Elecrow-RD/All-in-one_Starter_Kit_for_Arduino/schematic diagram/All_in_one Starter Kit for Arduino_V1.0.pdf

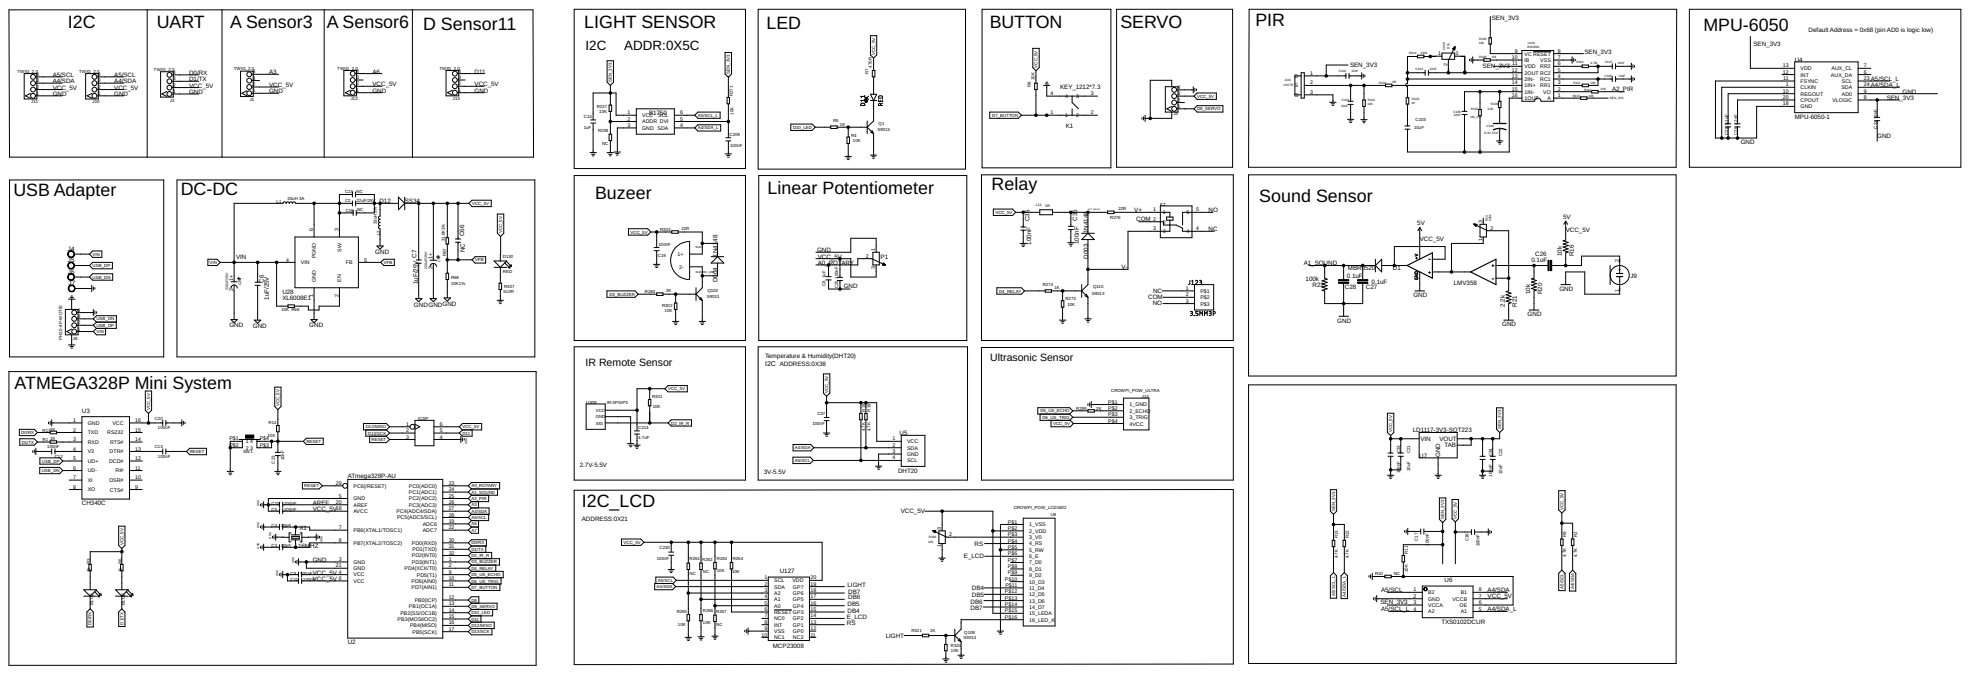
[picture p1: page 1]
