Elecrow-RD/All-in-one_Starter_Kit_for_Arduino/schematic diagram/All_in_one Starter Kit for Arduino_V1.0.brd

## EAGLE design schematic diagram/All_in_one Starter Kit for Arduino_V1.0.brd (2025-01-15)

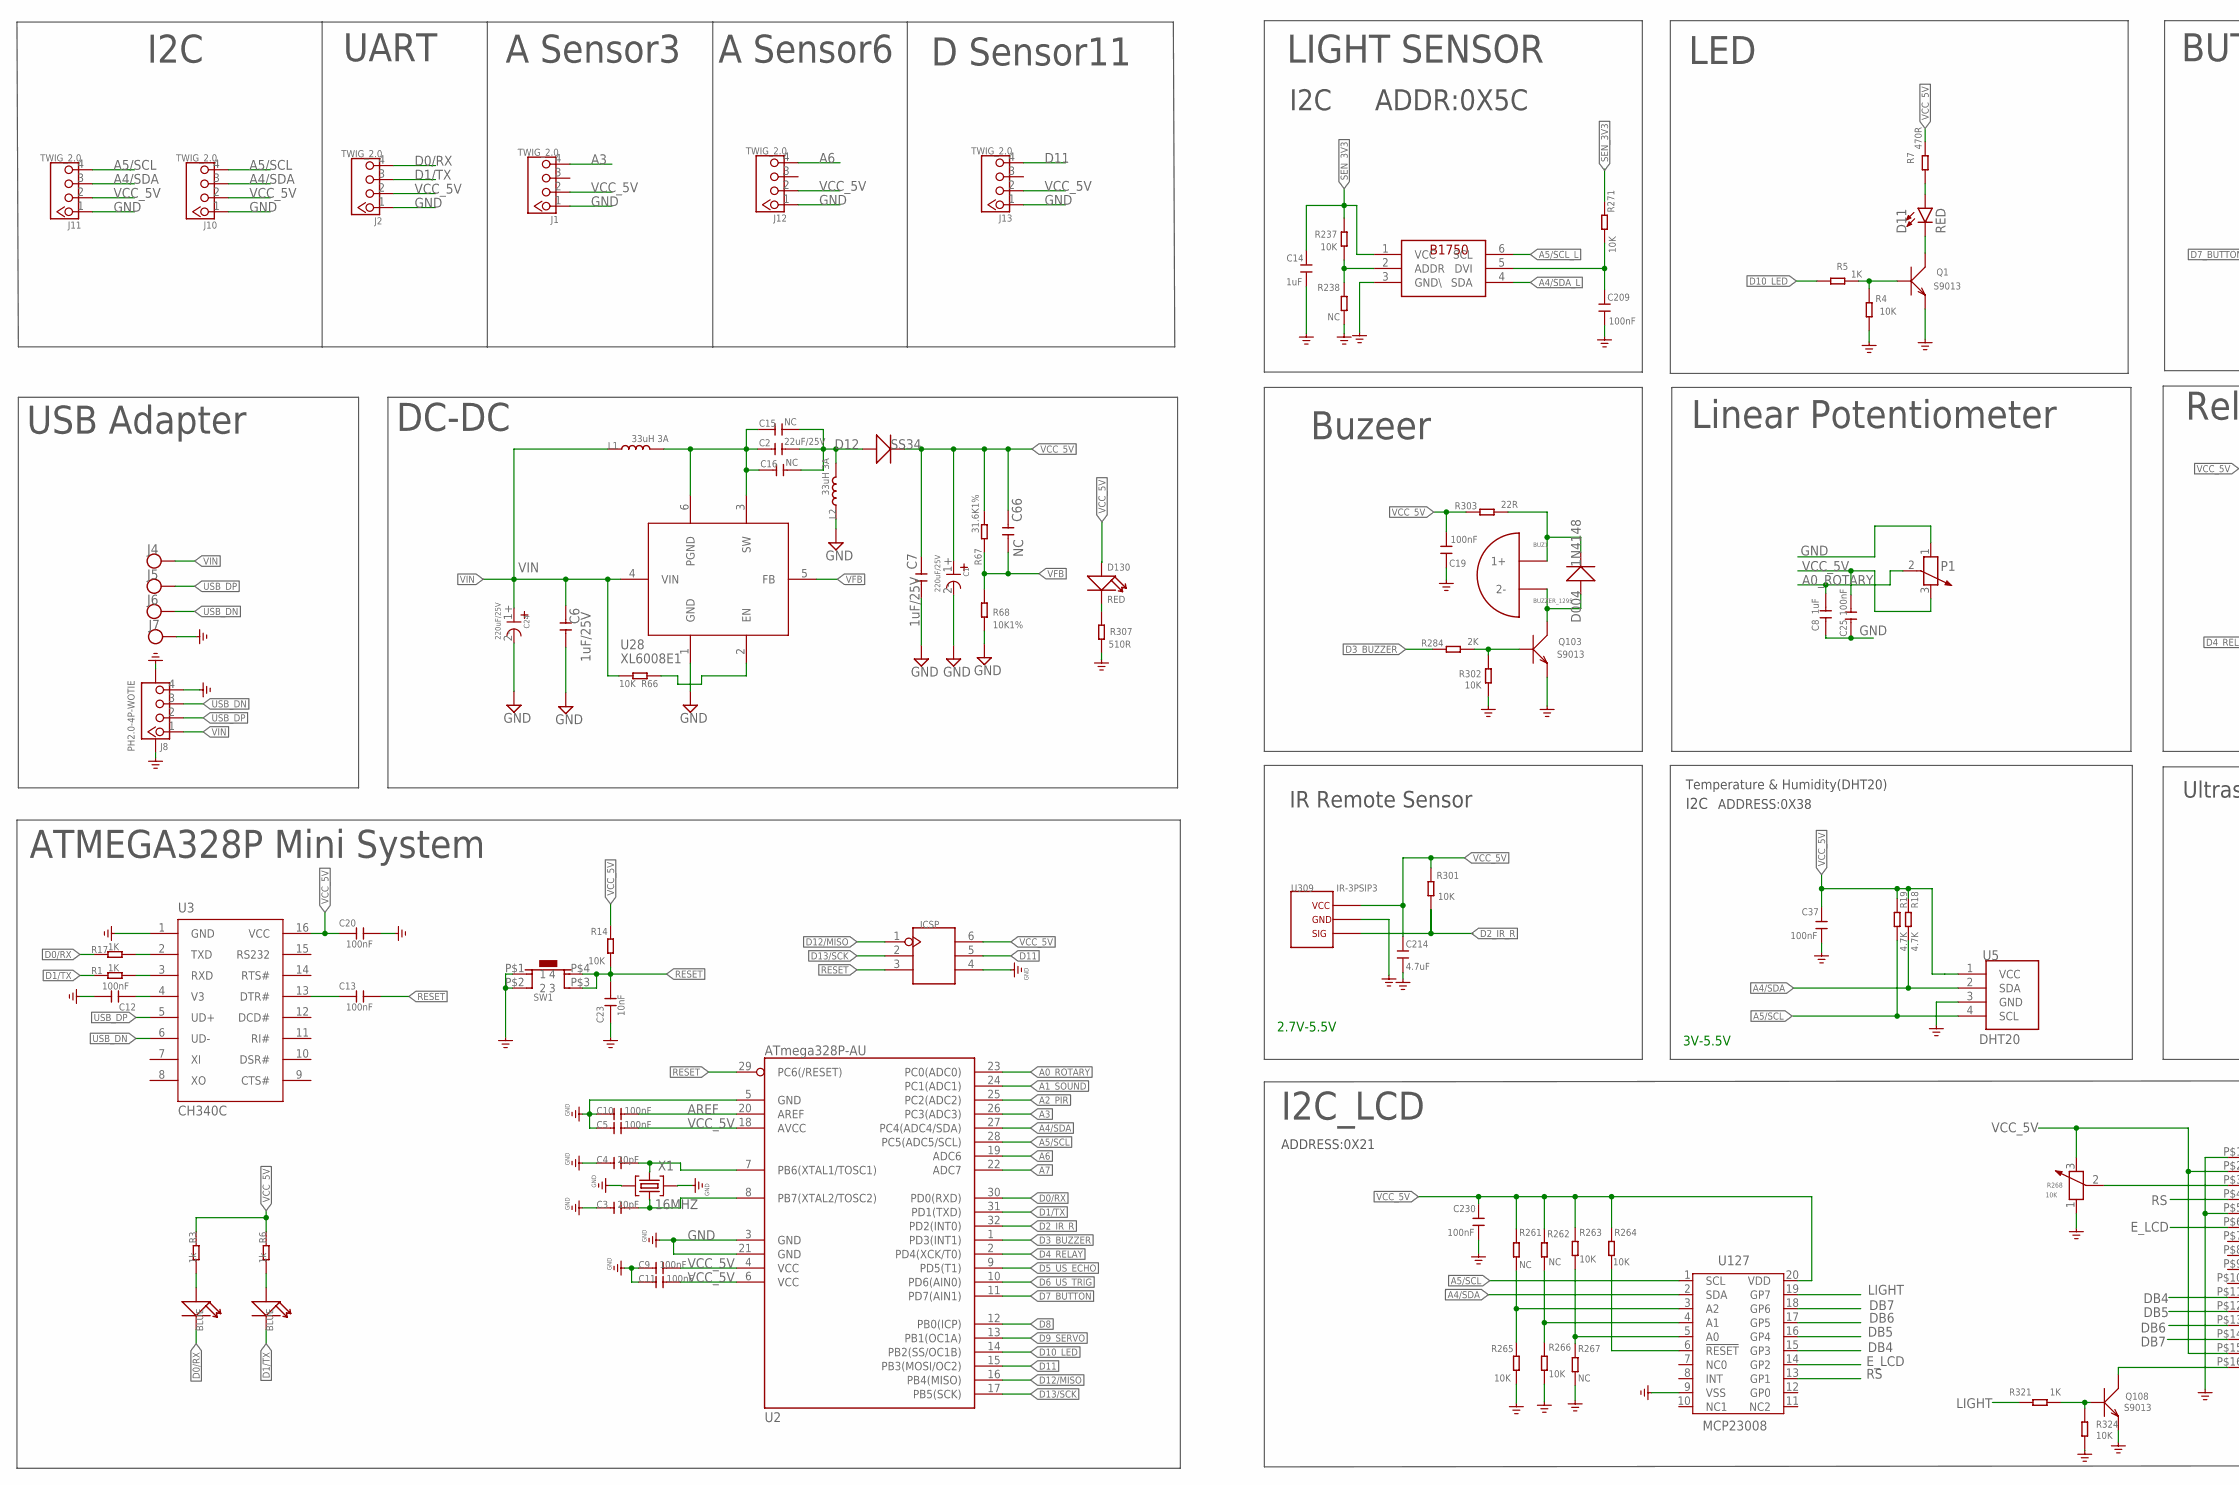
[picture p2: schematic All_in_one Starter Kit for Arduino_V1.0.sch, part in row 1, column 1]

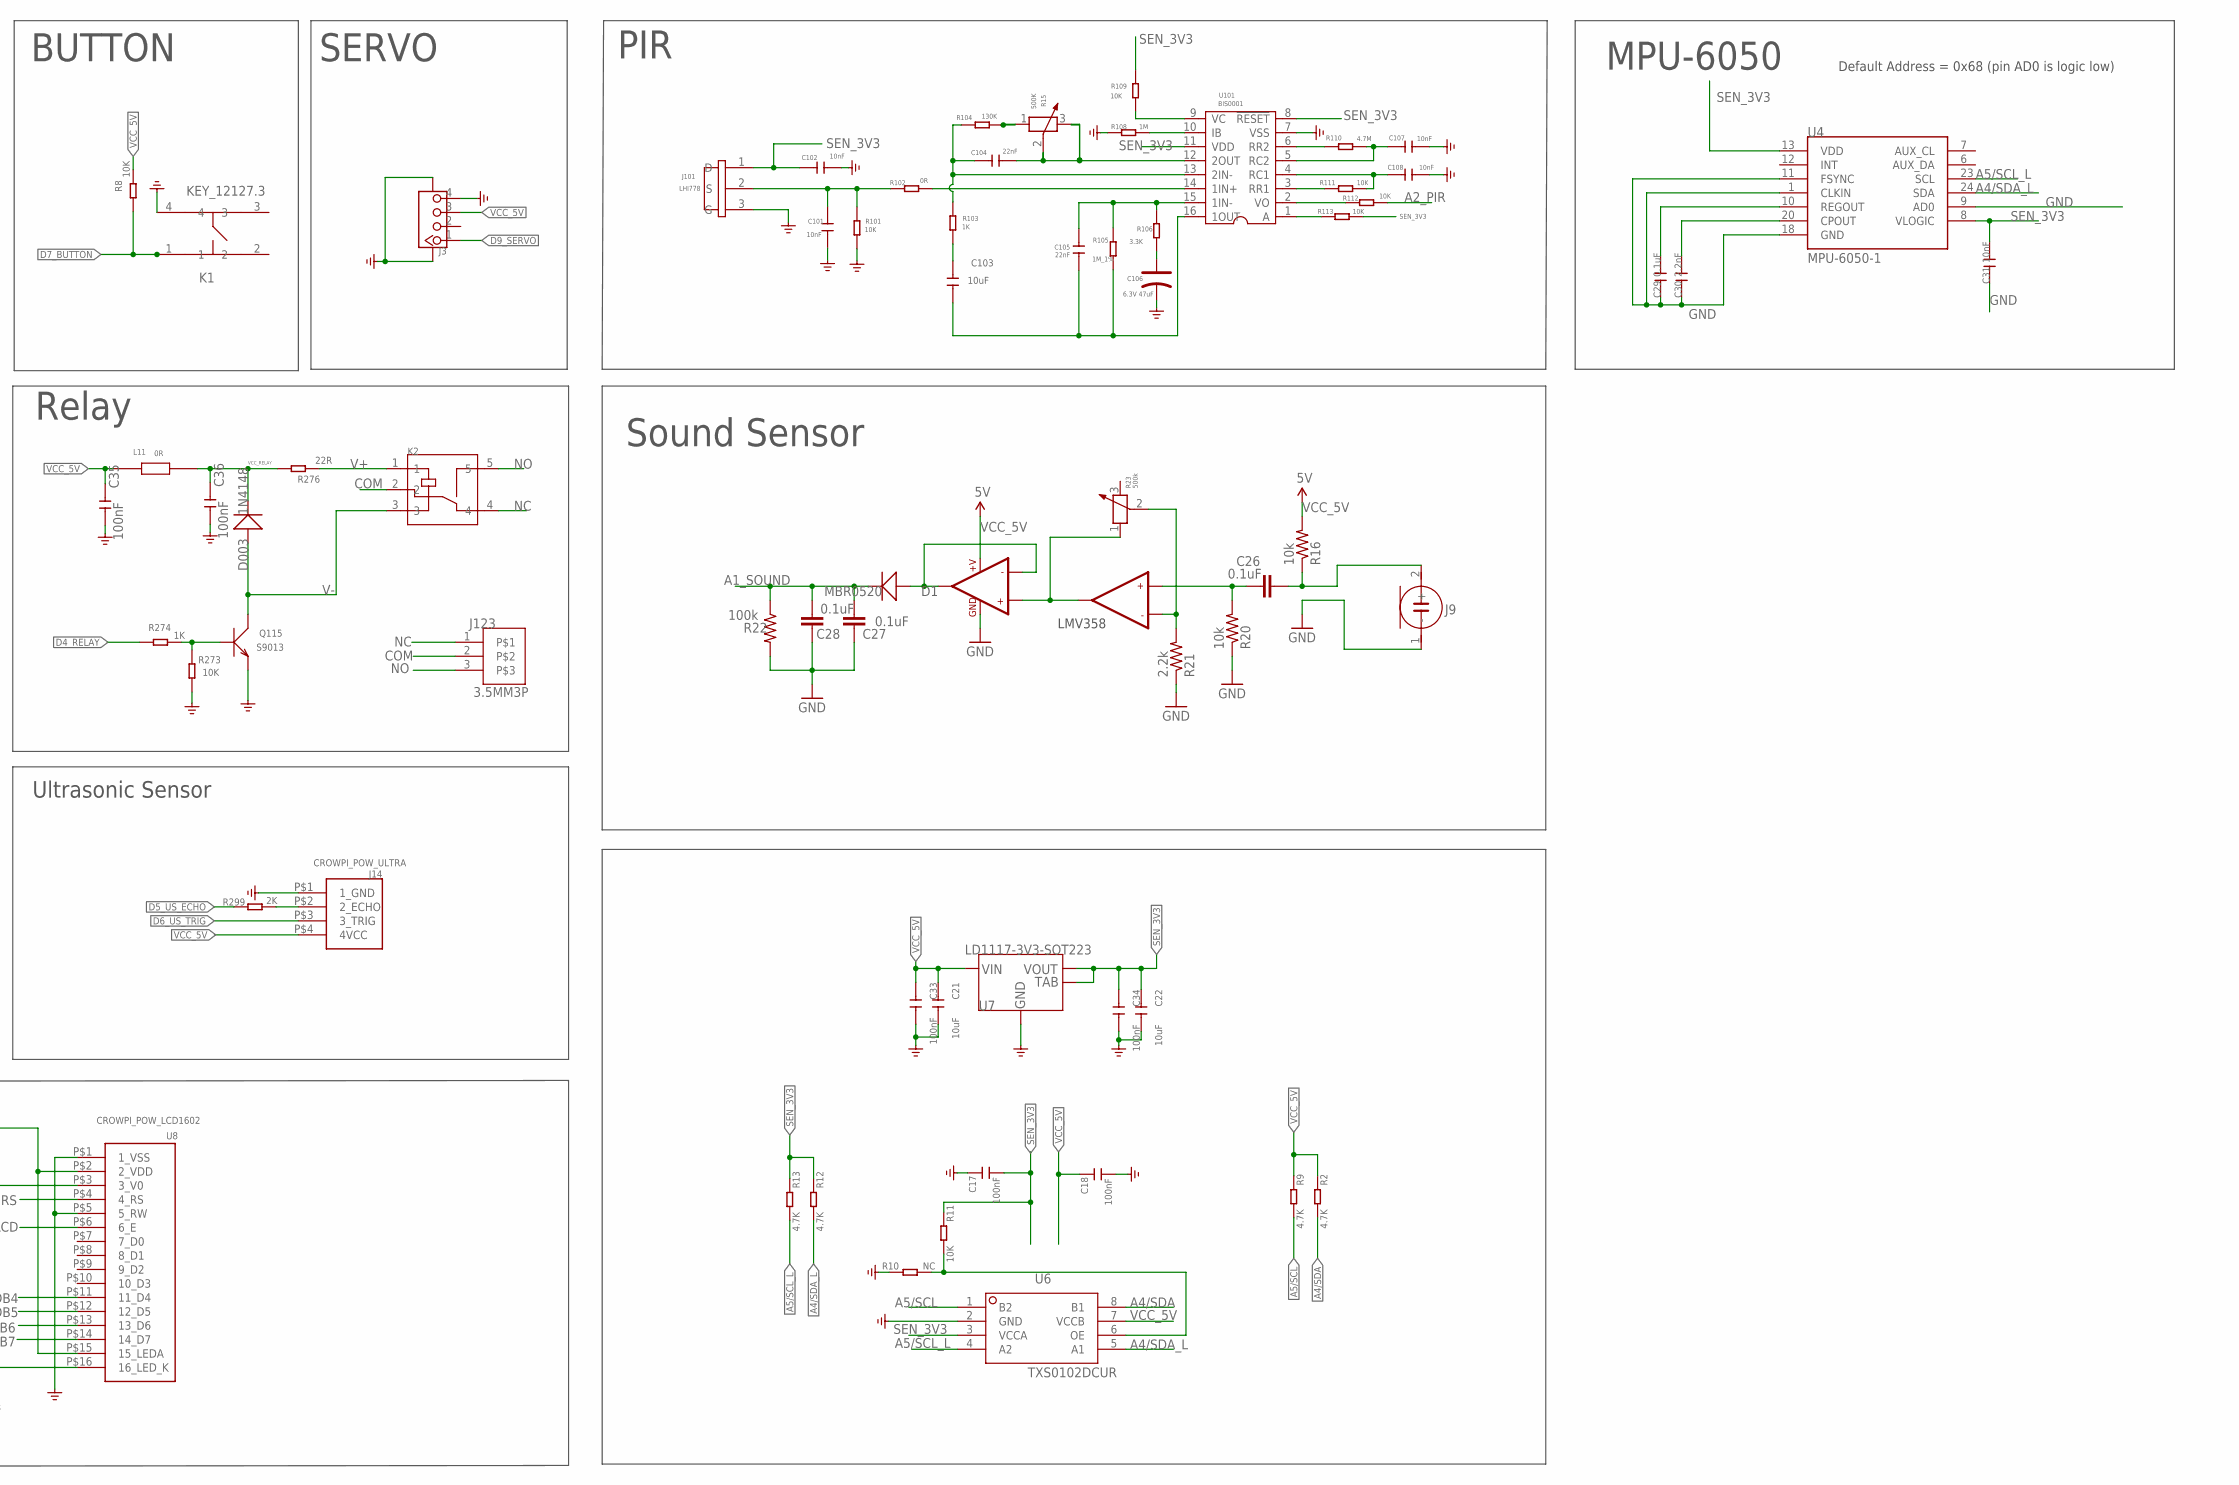
[picture p3: schematic All_in_one Starter Kit for Arduino_V1.0.sch, part in row 1, column 2]

Parts:
BUZ1: BUZZER_1295; BUZZER-D12MM-DIP2
C1, C24: 220uF/25V; CAP_SMD_6.3*5.4MM
C2: 22uF/25V; C0805
C3, C4: 20pF; C0603
C5, C9, C10, C11, C12, C13, C20, C25, C33, C34, C35, C36: 100nF; C0603
C6, C7: 1uF/25V; C0603
C8: 1uF; C0603
C14: 1uF; 0603
C15, C16: NC; C0805
C17, C18, C19, C37, C209, C230: 100nF; 0603
C21, C22: 10uF; C0603
C23, C31, C101, C102, C107, C108: 10nF; C0603
C26, C27, C28: 0.1uF; 0603-CAP
C29: 0.1uF; C0603
C30: 2.2nF; C0603
C66: NC; C0603
C103: 10uF; 0603
C104, C105: 22nF; C0603
C106: 6.3V 47uF; AVX-A
C214: 4.7uF; 0603
D1: MBR0520; SOD123-2.7X1.6
D003, D004: 1N4148; D_SOD123
D11: RED; LED-8MM
D12: SS34; SMA
D13, D14: BLUE; LED-0603
D130: RED; LED_0603_SMT
ICSP: 2.54-2x3p male; 2X3P-2.54
J1, J2, J10, J11, J12, J13: TWIG_2.0; 2.0_1X4
J3: A_XBJ_CONNECTOR_TWIG-4P-2.0-SMD-FEMALE-REINFORCE9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; A_XBJ_CONNECTOR_4P-SMD-2.0-90D
J4, J5, J6, J7: TP-SMDTP-SMD-2X4MM; TP-SMD-2X4MM
J8: PH2.0-4P-WOTIE; PH2.0-4P
J9: TEMPLATE_MIC-6MM; TEMPLATE_2P-D6MM
J14: CROWPI_POW_ULTRA
J101: LHI778; 3P-D8.1MM
J123: 3.5MM3P; 3.5MM*3P
K1: KEY_12127.3; KEY_12*12*7.3
K2: RELAY-SRD; REY5-6-19.1X15.5X15.3MM
L1, L2: 33uH 3A; L1040-SMD
L11: 0R; 201209
P1: R-POTENTIOMETER; 3P-SQUA-45.6X10X5.8H
Q1, Q103, Q108, Q115: S9013; SOT23@1
R1, R5, R17, R103, R274, R321: 1K; R0603
R2, R9, R12, R13, R18, R19: 4.7K; R0603
R3, R6: 1k; R0603
R4, R8, R11, R14, R66, R101, R109, R111, R112, R113, R237, R263, R264, R265, R266, R271, R273, R301, R302, R324: 10K; R0603
R7: 470R; R0603
R10, R238, R261, R262, R267: NC; R0603
R15: 500K; 3P-SMD-SQUA-3.6X3.3
R16, R20: 10k; 0603-RES
R21: 2.2k; 0603-RES
R22: 100k; 0603-RES
R23: 500k; 3P-SMD-SQUA-3.6X3.3
R67: 31.6K1%; R0603
R68: 10K1%; R0603
R102: 0R; R0603
R104: 130K; R0603
R105: 1M_1%; R0603
R106: 3.3K; R0603
R108: 1M; R0603
R110: 4.7M; R0603
R268: 10K; 3P-SMD-SQUA-3.6X3.3
R276, R303: 22R; R0603
R284, R299: 2K; R0603
R307: 510R; R0603
SW1: BUTTON-4P-SMD4.2X3.2; BUTTON-SMD4P-4.2X3.2X2.5
U1: LMV358; SO08
U2: ATmega328P-AU; TQFP32
U3: CH340C; SOP-16
U4: MPU-6050-1; QFN-24-4MM2
U5: DHT20; CROWTAIL-DHT20-V1.0-20211013_DHT20
U6: TXS0102DCUR; VSSOP-8
U7: LD1117-3V3-SOT223; SOT223
U8: CROWPI_POW_LCD1602; CROWPI_POW_LCD1206
U28: XL6008E1; TO252-5
U101: BIS0001; SOP16
U121: BH1750; BH1750-WSOF-6
U127: MCP23008; SSOP20
U309: IR-3PSIP3; VS1838B-SIP3
X1: 16MHZ; CRYSTAL-3.2-2.5

Connections:
A0_ROTARY: C8.2, P1.2 (3), U2.23 (PC0(ADC0))
A1_SOUND: C27.2, C28.2, D1.2 (-), R22.1, U2.24 (PC1(ADC1))
A2_PIR: R112.1, U2.25 (PC2(ADC2))
A3: J1.4, U2.26 (PC3(ADC3))
A4/SDA: J10.3, J11.3, R2.2, R18.2, U2.27 (PC4(ADC4/SDA)), U5.2 (SDA), U6.8 (B1), U127.2 (SDA)
A4/SDA_L: R12.2, U4.24 (SDA), U6.5 (A1), U121.4 (SDA)
A5/SCL: J10.4, J11.4, R9.2, R19.2, U2.28 (PC5(ADC5/SCL)), U5.4 (SCL), U6.1 (B2), U127.1 (SCL)
A5/SCL_L: R13.2, U4.23 (SCL), U6.4 (A2), U121.6 (SCL)
A6: J12.4, U2.19 (ADC6)
A7: U2.22 (ADC7)
AREF: C10.2, U2.20 (AREF)
COM: J123.2, K2.2
D0/RX: D13.-, J2.4, R17.1, U2.30 (PD0(RXD))
D1/TX: D14.-, J2.3, R1.1, U2.31 (PD1(TXD))
D2_IR_R: R301.2, U2.32 (PD2(INT0)), U309.3
D3_BUZZER: R284.1, U2.1 (PD3(INT1))
D4_RELAY: R274.2, U2.2 (PD4(XCK/T0))
D5_US_ECHO: R299.2, U2.9 (PD5(T1))
D6_US_TRIG: J14.P$3 (3_TRIG), U2.10 (PD6(AIN0))
D7_BUTTON: K1.1, R8.2, U2.11 (PD7(AIN1))
D8: U2.12 (PB0(ICP))
D9_SERVO: J3.1, U2.13 (PB1(OC1A))
D10_LED: R5.2, U2.14 (PB2(SS/OC1B))
D11: ICSP.5, J13.4, U2.15 (PB3(MOSI/OC2))
D12/MISO: ICSP.1, U2.16 (PB4(MISO))
D13/SCK: ICSP.2, U2.17 (PB5(SCK))
DB4: U8.P$11 (11_D4), U127.15 (GP3)
DB5: U8.P$12 (12_D5), U127.16 (GP4)
DB6: U8.P$13 (13_D6), U127.17 (GP5)
DB7: U8.P$14 (14_D7), U127.18 (GP6)
E_LCD: U8.P$6 (6_E), U127.14 (GP2)
GND: C1.2-, C3.1, C4.1, C5.1, C6.1, C7.1, C8.1, C9.1, C10.1, C11.1, C12.2, C14.1, C17.2, C18.1, C19.2, C20.2, C21.2, C22.2, C23.1, C24.2-, C25.1, C27.1, C28.1, C29.1, C30.1, C31.1, C33.2, C34.2, C35.1, C36.1, C37.1, C101.1, C102.1, C106.-, C107.2, C108.2, C209.1, C214.1, C230.1, ICSP.4, J1.1, J2.1, J3.4, J3.SS1, J3.SS2, J7.1, J8.4, J8.5 (SS1), J8.6 (SS2), J9.1 (-), J10.1, J11.1, J12.1, J13.1, J14.P$1 (1_GND), J101.3 (G), K1.4, L2.1, P1.1, Q1.2 (E), Q103.2 (E), Q108.2 (E), Q115.2 (E), R4.1, R10.1, R20.1, R21.1, R22.2, R68.2, R101.1, R108.1, R238.1, R265.2, R266.2, R267.1, R268.1, R273.1, R302.1, R307.2, R324.2, SW1.P$1 (1), SW1.P$2 (2), U1.4 (GND), U2.3 (GND), U2.5 (GND), U2.21 (GND), U3.1 (GND), U4.1 (CLKIN), U4.9 (AD0), U4.11 (FSYNC), U4.18 (GND), U5.3 (GND), U6.2 (GND), U7.1 (GND), U8.P$1 (1_VSS), U8.P$5 (5_RW), U28.1 (GND), U101.7 (VSS), U121.3 (GND\), U127.9 (VSS), U309.2, X1.2 (GND), X1.4 (GND)
LIGHT: R321.2, U127.19 (GP7)
unnamed: R111.1, U101.3 (RR1)
unnamed: Q108.1 (B), R321.1, R324.1
unnamed: R261.1, R265.1, U127.3 (A2)
unnamed: R262.1, R266.1, U127.4 (A1)
unnamed: R263.2, R267.2, U127.5 (A0)
unnamed: R264.2, U127.6 (!RESET)
unnamed: R268.2 (3), U8.P$3 (3_V0)
unnamed: D13.+, R3.2
unnamed: C12.1, U3.4 (V3)
unnamed: C13.1, U3.13 (DTR#)
unnamed: C4.2, U2.7 (PB6(XTAL1/TOSC1)), X1.3 (C2)
unnamed: C3.2, U2.8 (PB7(XTAL2/TOSC2)), X1.1 (C1)
unnamed: C108.1, R111.2, U101.4 (RC1)
unnamed: Q1.1 (B), R4.2, R5.1
unnamed: D11.2 (C), Q1.3 (C)
unnamed: D11.1 (A), R7.2
unnamed: D14.+, R6.2
unnamed: R66.1, U28.2 (EN)
unnamed: C2.2, C15.2, C16.2, D12.2 (+), L2.2
unnamed: Q108.3 (C), U8.P$16 (16_LED_K)
unnamed: R112.2, U101.2 (VO)
unnamed: R17.2, U3.2 (TXD)
unnamed: R1.2, U3.3 (RXD)
unnamed: R10.2, R11.2, U6.6 (OE)
unnamed: R110.2, U101.6 (RR2)
unnamed: C107.1, R110.1, U101.5 (RC2)
unnamed: C104.2, R15.2 (3), R15.3 (2), U101.12 (2OUT)
unnamed: C104.1, R103.2, R104.2, U101.13 (2IN-)
unnamed: R109.2, U101.9 (VC)
unnamed: R108.2, U101.10 (IB)
unnamed: C101.2, J101.2 (S), R101.2, R102.2
unnamed: C103.2, C105.1, R105.1, U101.16 (1OUT)
unnamed: C105.2, R105.2, R106.2, U101.15 (1IN-)
unnamed: C209.2, R271.2, U121.5 (DVI)
unnamed: C103.1, R103.1
unnamed: C106.+, R106.1
unnamed: R113.2, U101.1 (A)
unnamed: R102.1, U101.14 (1IN+)
unnamed: R15.1, R104.1
unnamed: C26.1, J9.2 (+), R16.1
unnamed: C26.2, R20.2, U1.5 (+IN2)
unnamed: R21.2, R23.2 (3), U1.6 (-IN2)
unnamed: D1.1 (+), U1.1 (OUT1), U1.2 (-IN1)
unnamed: R23.1, U1.3 (+IN1), U1.7 (OUT2)
unnamed: C29.2, U4.10 (REGOUT)
unnamed: C30.2, U4.20 (CPOUT)
unnamed: D130.2 (2_K), R307.1
unnamed: C2.1, C15.1, C16.1, L1.2, U28.3 (SW), U28.6 (PGND)
unnamed: R237.1, R238.2, U121.2 (ADDR)
unnamed: Q115.1 (B), R273.2, R274.1
unnamed: J14.P$2 (2_ECHO), R299.1
unnamed: Q103.1 (B), R284.2, R302.2
unnamed: BUZ1.2 (2-), D004.+, Q103.3 (C)
unnamed: BUZ1.1 (1+), D004.-, R303.2
NC: J123.1, K2.4
NO: J123.3, K2.5
RESET: C13.2, C23.2, ICSP.3, R14.2, SW1.P$3 (3), SW1.P$4 (4), U2.29 (PC6(/RESET))
RS: U8.P$4 (4_RS), U127.13 (GP1)
SEN_3V3: C14.2, C17.1, C22.1, C31.2, C34.1, C102.2, J101.1 (D), R11.1, R12.1, R13.1, R109.1, R113.1, R237.2, R271.1, U4.8 (VLOGIC), U4.13 (VDD), U6.3 (VCCA), U7.2 (VOUT), U7.4 (TAB), U101.8 (!RESET), U101.11 (VDD), U121.1 (VCC)
USB_DN: J6.1, J8.3, U3.6 (UD-)
USB_DP: J5.1, J8.2, U3.5 (UD+)
V+: K2.1, R276.2
V-: D003.+, K2.3, Q115.3 (C)
VCC_5V: C1.1+, C5.2, C7.2, C9.2, C11.2, C18.2, C19.1, C20.1, C21.1, C25.2, C33.1, C35.2, C37.2, C66.2, C214.2, C230.2, D12.1 (-), D130.1 (1_A), ICSP.6, J1.2, J2.2, J3.3, J10.2, J11.2, J12.2, J13.2, J14.P$4 (4VCC), L11.1, P1.3 (2), R2.1, R3.1, R6.1, R7.1, R8.1, R9.1, R14.1, R16.2, R18.1, R19.1, R67.1, R261.2, R262.2, R263.1, R264.1, R268.3 (2), R301.1, R303.1, U1.8 (+V), U2.4 (VCC), U2.6 (VCC), U2.18 (AVCC), U3.16 (VCC), U5.1 (VCC), U6.7 (VCCB), U7.3 (VIN), U8.P$2 (2_VDD), U8.P$15 (15_LEDA), U127.20 (VDD), U309.1
VCC_RELAY: C36.2, D003.-, L11.2, R276.1
VFB: C66.1, R67.2, R68.1, U28.5 (FB)
VIN: C6.2, C24.1+, J4.1, J8.1, L1.1, R66.2, U28.4 (VIN)

Notes on the sheet:
I2C_LCD
LIGHT SENSOR
SERVO
Ultrasonic Sensor
IR Remote Sensor
I2C
Temperature & Humidity(DHT20)
Buzeer
PIR
Relay
2.7V-5.5V
3V-5.5V
ADDRESS:0X38
UART
ADDRESS:0X21
A Sensor3
A Sensor6
LED
BUTTON
Linear Potentiometer
DC-DC
ATMEGA328P Mini System
USB Adapter
ADDR:0X5C
Sound Sensor
LMV358
Default Address = 0x68 (pin AD0 is logic low)
MPU-6050
D Sensor11

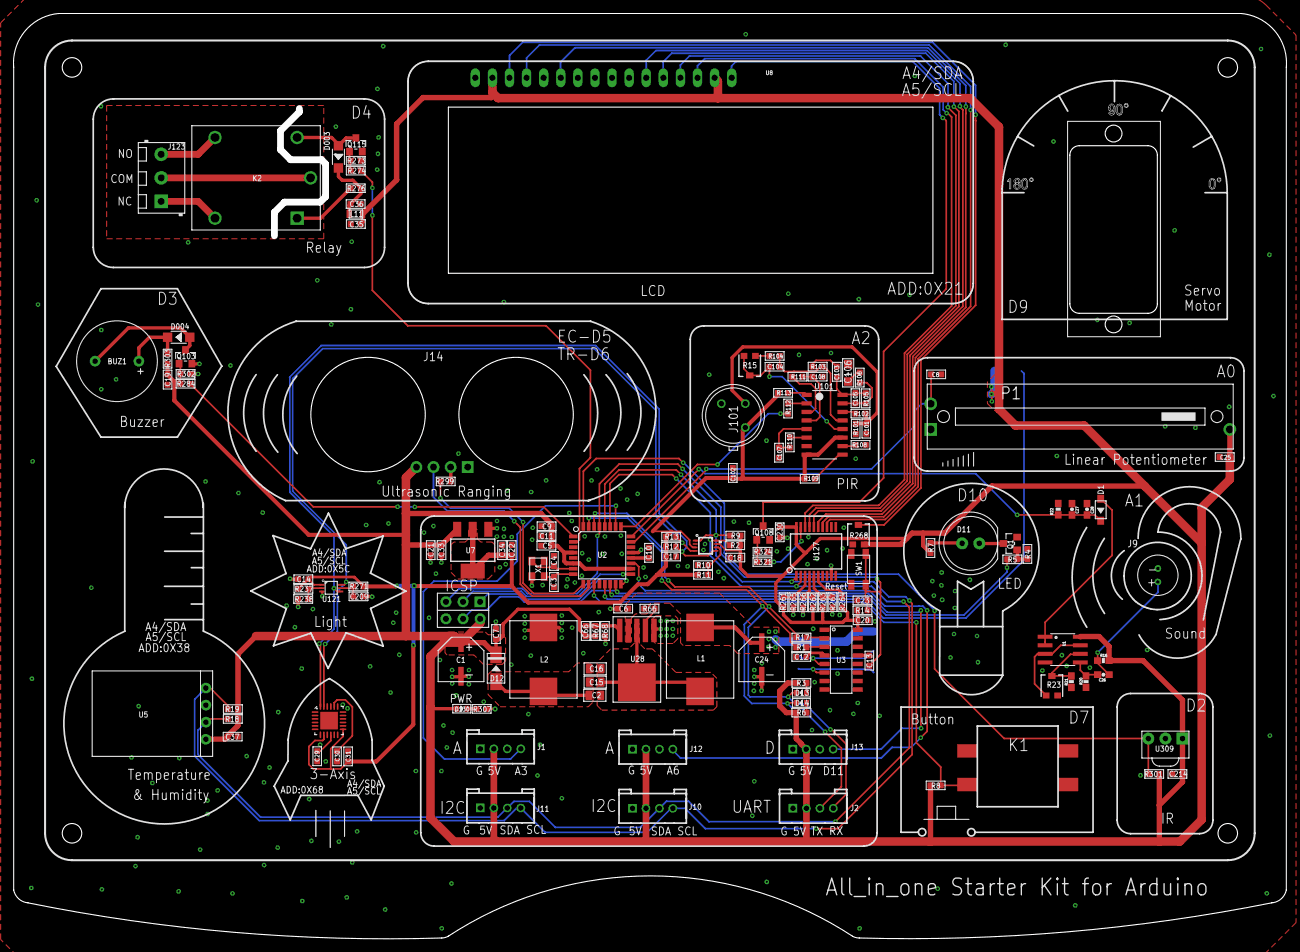
[picture p4: board All_in_one Starter Kit for Arduino_V1.0.brd from above]

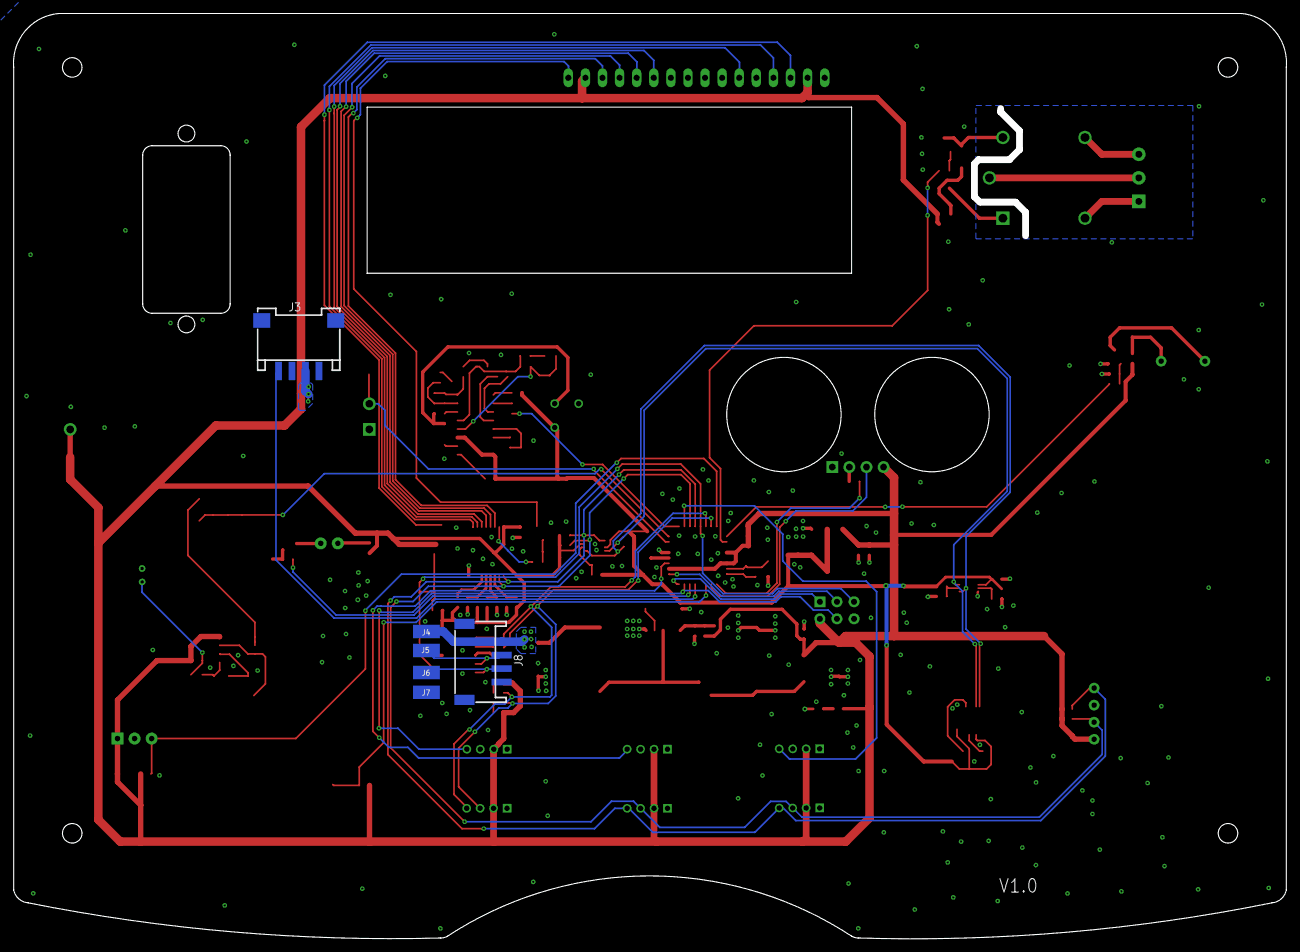
[picture p5: board All_in_one Starter Kit for Arduino_V1.0.brd from below]

Board: 2 copper layers, 189.2 x 137.5 mm, 159 parts (6 on the bottom side), 98 nets.
